thathvik/SnakeMic/Iter_3/README.md

# Third Iteration
This is the thrid itereation of the 3D model. This model can accomodate the large PCB of the Bose Soundlink Micro. 

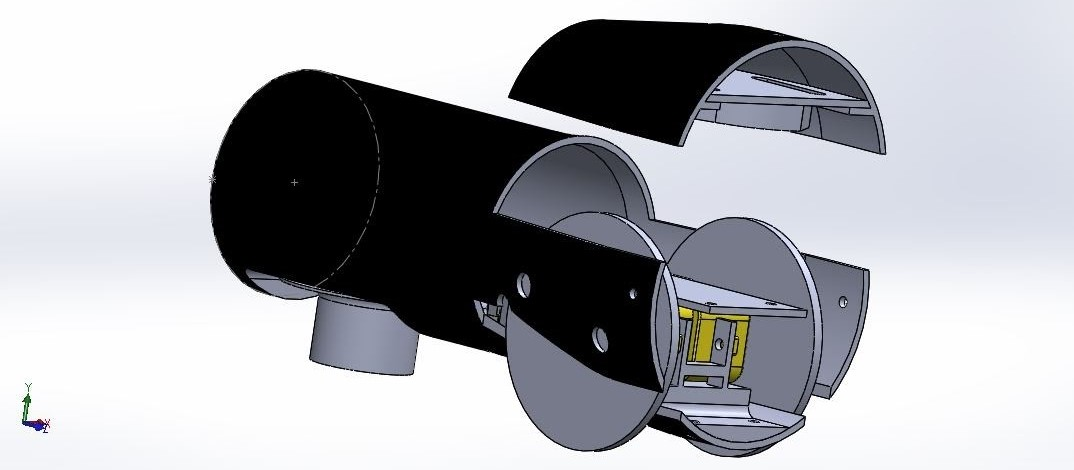
[picture p1: Iter_3/I_f.jpg]
The image of the 3D Model available in the .zip file
