thathvik/SnakeMic/(commit log)

2020-08-24 uploaded the Arduino_code file
    Initiated code and setup pins
2020-08-25 Added CAD files
2020-08-25 CAD files
